AdamC19/Linear_Lab_Power_Supply/CAD/Linear_PSU_case_LID_Rear.stl

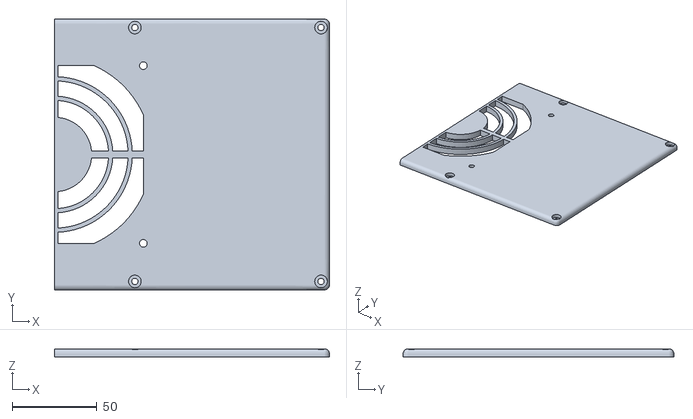
[picture p1: CAD file, 2022-03-09]
CAD/Linear_PSU_case_LID_Rear.stl
162.5 x 160.0 x 5.00
