AdamC19/Linear_Lab_Power_Supply/CAD/Linear_PSU_case_part_2.stl

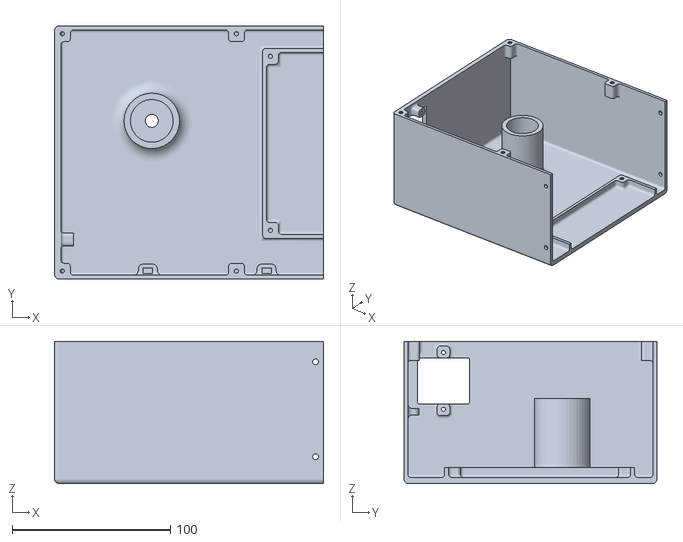
[picture p2: CAD file, 2022-03-09]
CAD/Linear_PSU_case_part_2.stl
170.0 x 160.0 x 90.0
