AdamC19/Linear_Lab_Power_Supply/CAD/Linear_PSU_part_1.stl

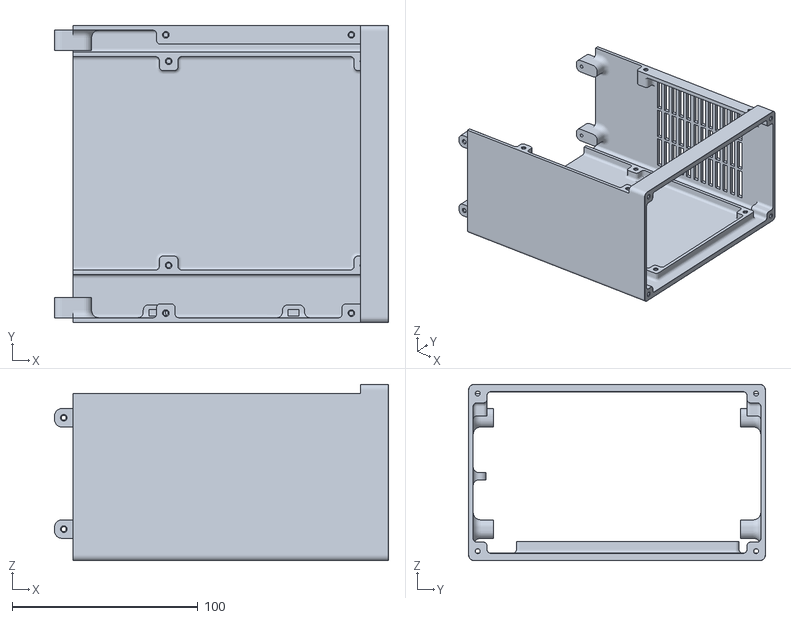
[picture p3: CAD file, 2022-03-09]
CAD/Linear_PSU_part_1.stl
180.0 x 160.0 x 95.0
