AdamC19/Linear_Lab_Power_Supply/(list of files, cad)

Other CAD files:
CAD/Linear_PSU_case_LID_Front.stl
