AdamC19/Linear_Lab_Power_Supply/Linear_Lab_Bench_PSU_front_panel/Linear_Lab_Bench_PSU_front_panel.kicad_pcb

## KiCad design Linear_Lab_Bench_PSU_front_panel/Linear_Lab_Bench_PSU_front_panel.kicad_pcb (2022-03-08)

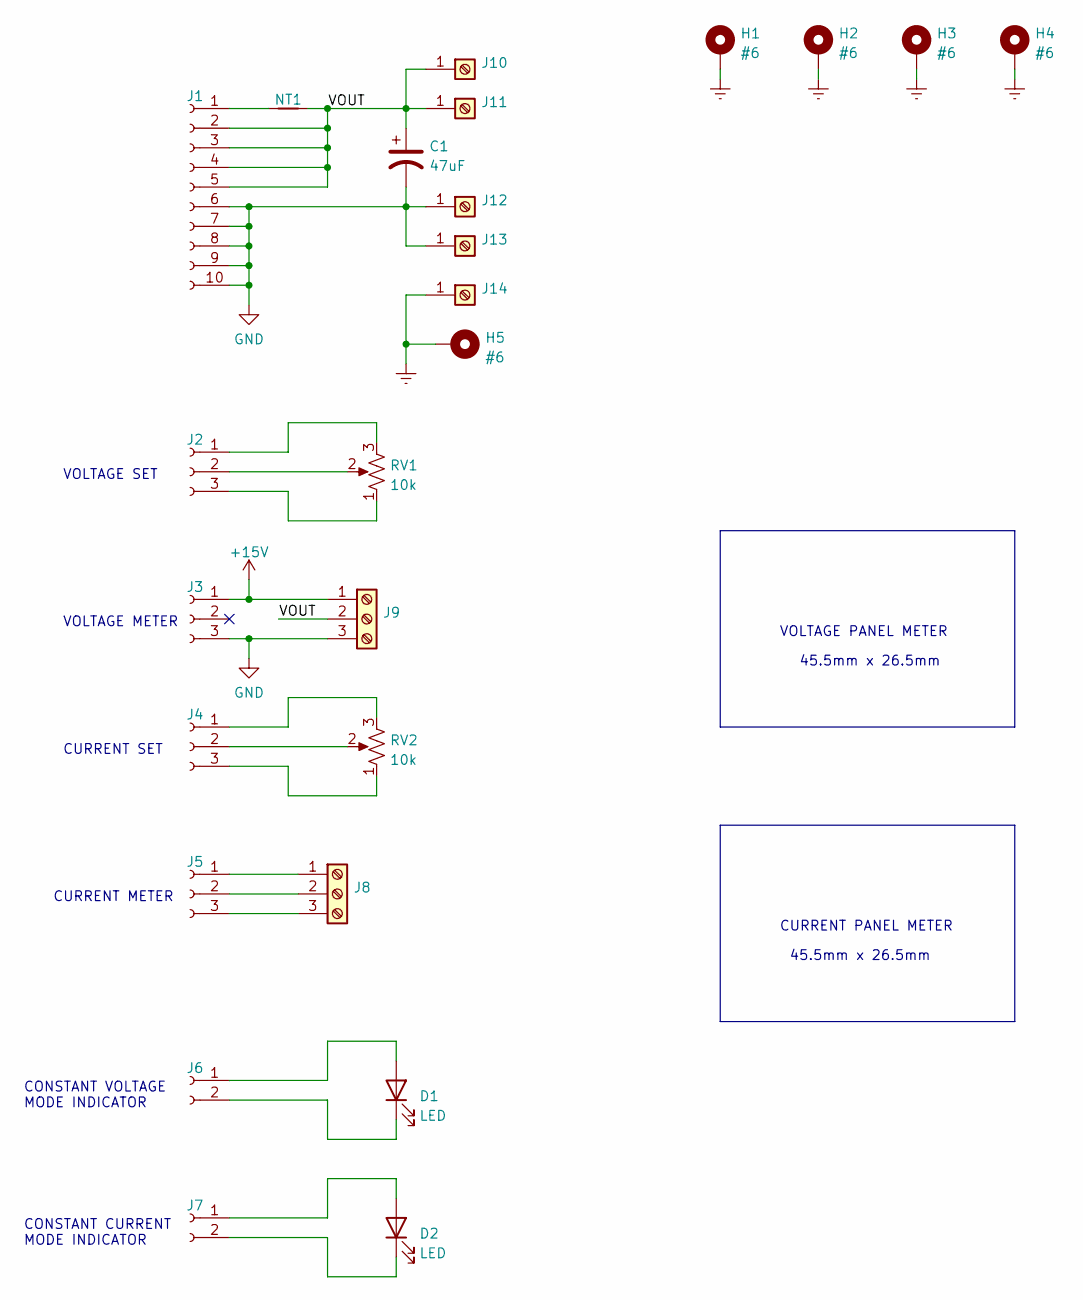
[picture p4: schematic Linear_Lab_Bench_PSU_front_panel.kicad_sch]

Parts:
C1: 47uF; CP_Radial_D8.0mm_P3.50mm
D1, D2: LED; LED_D5.0mm
H1, H2, H3, H4, H5: #6; MountingHole_3.7mm_Pad
J1: Conn_01x10_Female; PinSocket_1x10_P2.54mm_Vertical
J2, J3, J4, J5: Conn_01x03_Female; PinSocket_1x03_P2.54mm_Vertical
J6, J7: Conn_01x02_Female; PinSocket_1x02_P2.54mm_Vertical
J8, J9: Screw_Terminal_01x03; PhoenixContact_MCV_1,5_3-G-3.81_1x03_P3.81mm_Vertical
J10, J11, J12, J13, J14: Screw_Terminal_01x01; MountingHole_5.3mm_M5_Pad_Via
NT1: NetTie_2; NetTie-2_SMD_Pad0.5mm
RV1, RV2: 10k; Pot_TT_P160KNPD-4FC

Connections:
+15V: J3.1, J9.1
/VOUT: C1.1, J1.2, J1.3, J1.4, J1.5, J9.2, J10.1, J11.1, NT1.2
Earth: H1.1, H2.1, H3.1, H4.1, H5.1, J14.1
GND: C1.2, J1.6, J1.7, J1.8, J1.9, J1.10, J3.3, J9.3, J12.1, J13.1
unnamed: D1.1 (K), J6.2
unnamed: D1.2 (A), J6.1
unnamed: D2.1 (K), J7.2
unnamed: D2.2 (A), J7.1
unnamed: J1.1, NT1.1
unnamed: J2.1, RV1.3
unnamed: J2.2, RV1.2
unnamed: J2.3, RV1.1
unnamed: J4.1, RV2.3
unnamed: J4.2, RV2.2
unnamed: J4.3, RV2.1
unnamed: J5.1, J8.1
unnamed: J5.2, J8.2
unnamed: J5.3, J8.3

Notes on the sheet:
45.5mm x 26.5mm
VOLTAGE METER
CURRENT PANEL METER
CURRENT METER
VOLTAGE PANEL METER
CONSTANT CURRENT MODE INDICATOR
CURRENT SET
VOLTAGE SET
CONSTANT VOLTAGE MODE INDICATOR

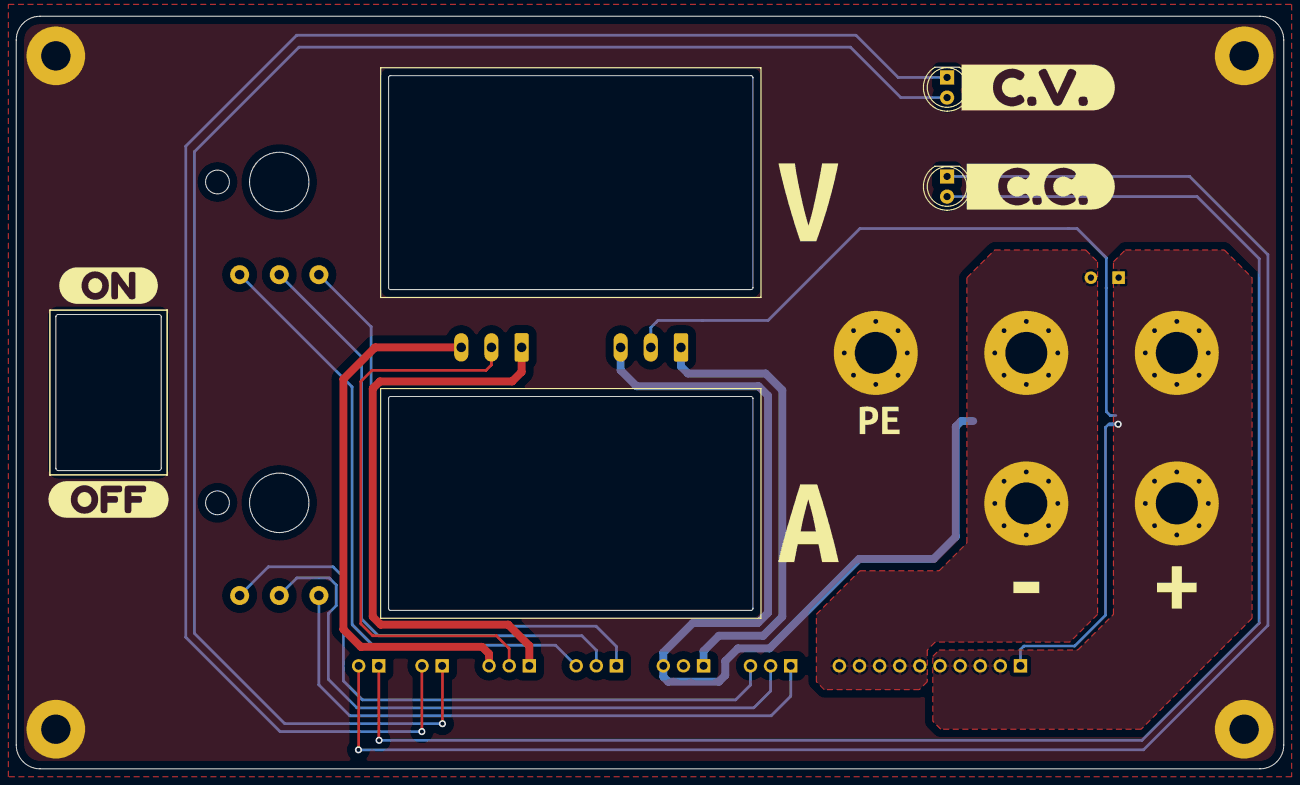
[picture p5: board Linear_Lab_Bench_PSU_front_panel.kicad_pcb from above]

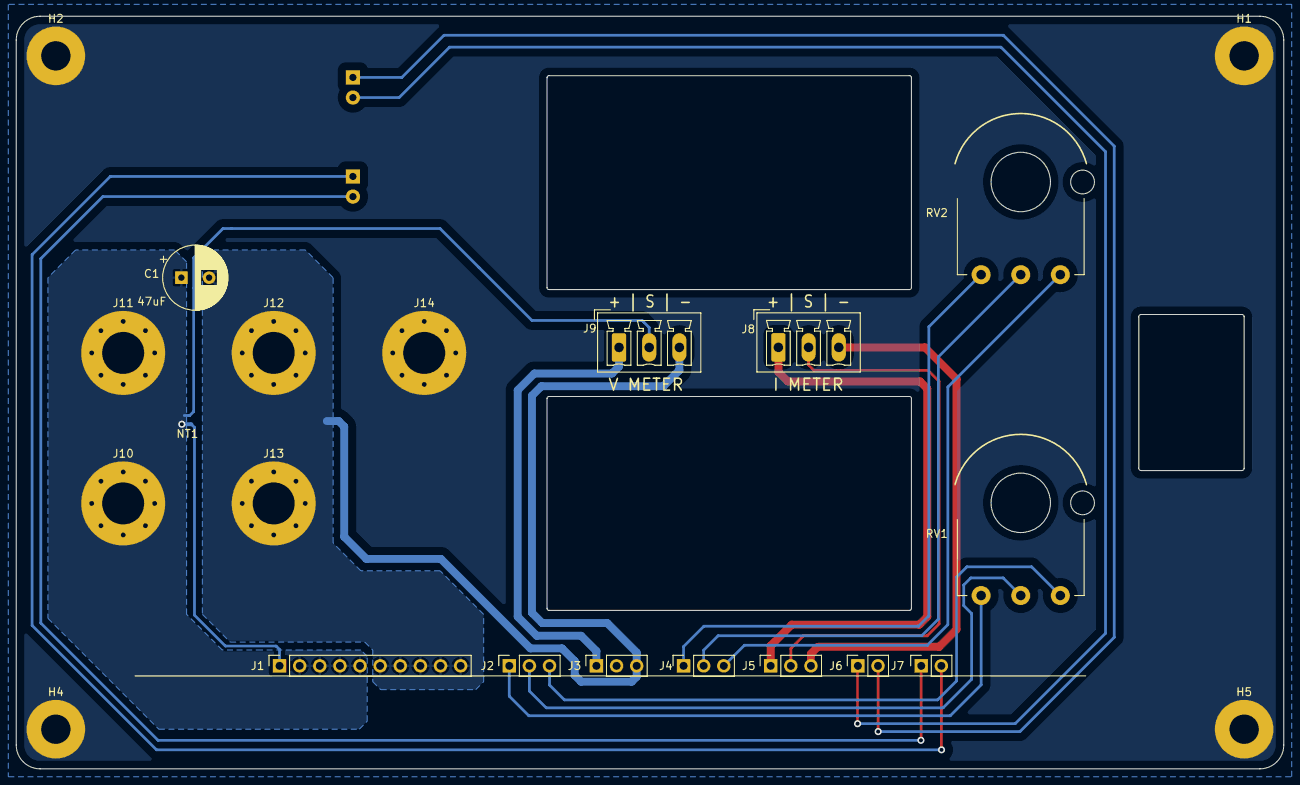
[picture p6: board Linear_Lab_Bench_PSU_front_panel.kicad_pcb from below]

Board: 2 copper layers, 160.0 x 95.0 mm, 33 parts (22 on the bottom side), 18 nets.

Other parts of the board:
kibuzzard-6225A7BC: G***; kibuzzard-6225A7BC
kibuzzard-6225A7C7: G***; kibuzzard-6225A7C7
kibuzzard-6225A77E: G***; kibuzzard-6225A77E
kibuzzard-6225A745: G***; kibuzzard-6225A745
kibuzzard-6225A755: G***; kibuzzard-6225A755
kibuzzard-62263B3C: G***; kibuzzard-62263B3C
kibuzzard-62263B33: G***; kibuzzard-62263B33
kibuzzard-62263C4A: G***; kibuzzard-62263C4A
kibuzzard-62263C42: G***; kibuzzard-62263C42
