AdamC19/Linear_Lab_Power_Supply/Linear_Lab_Bench_PSU_main/Linear_Lab_Bench_PSU.kicad_pcb

## KiCad design Linear_Lab_Bench_PSU_main/Linear_Lab_Bench_PSU.kicad_pcb (2022-03-08)

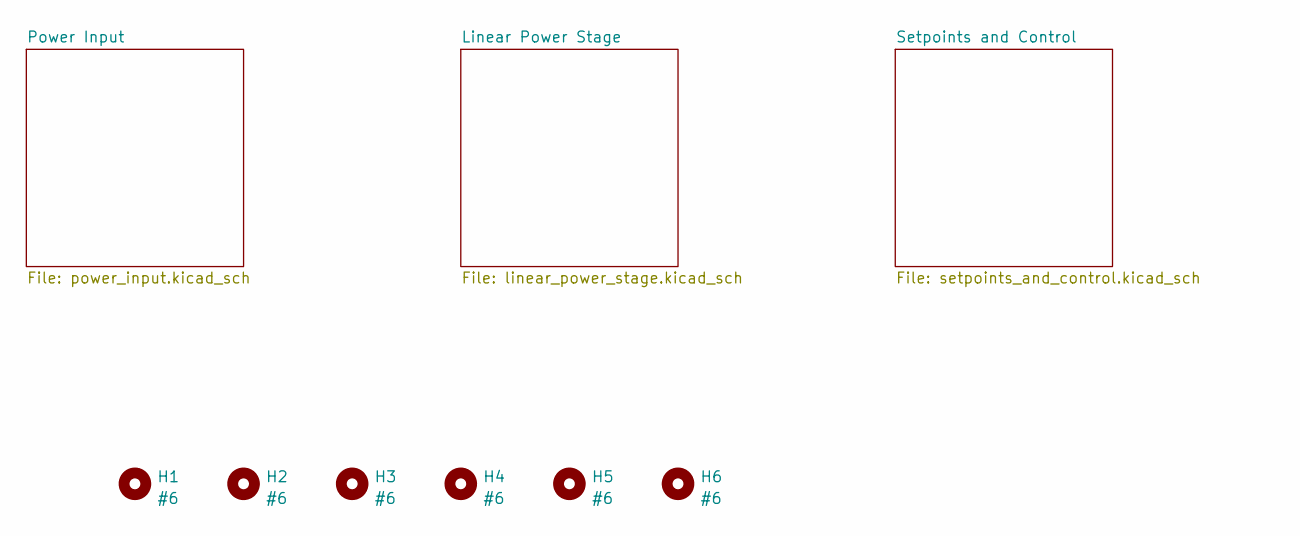
[picture p7: schematic Linear_Lab_Bench_PSU.kicad_sch]

Parts:
H1, H2, H3, H4, H5, H6: #6; MountingHole_3.7mm_Pad

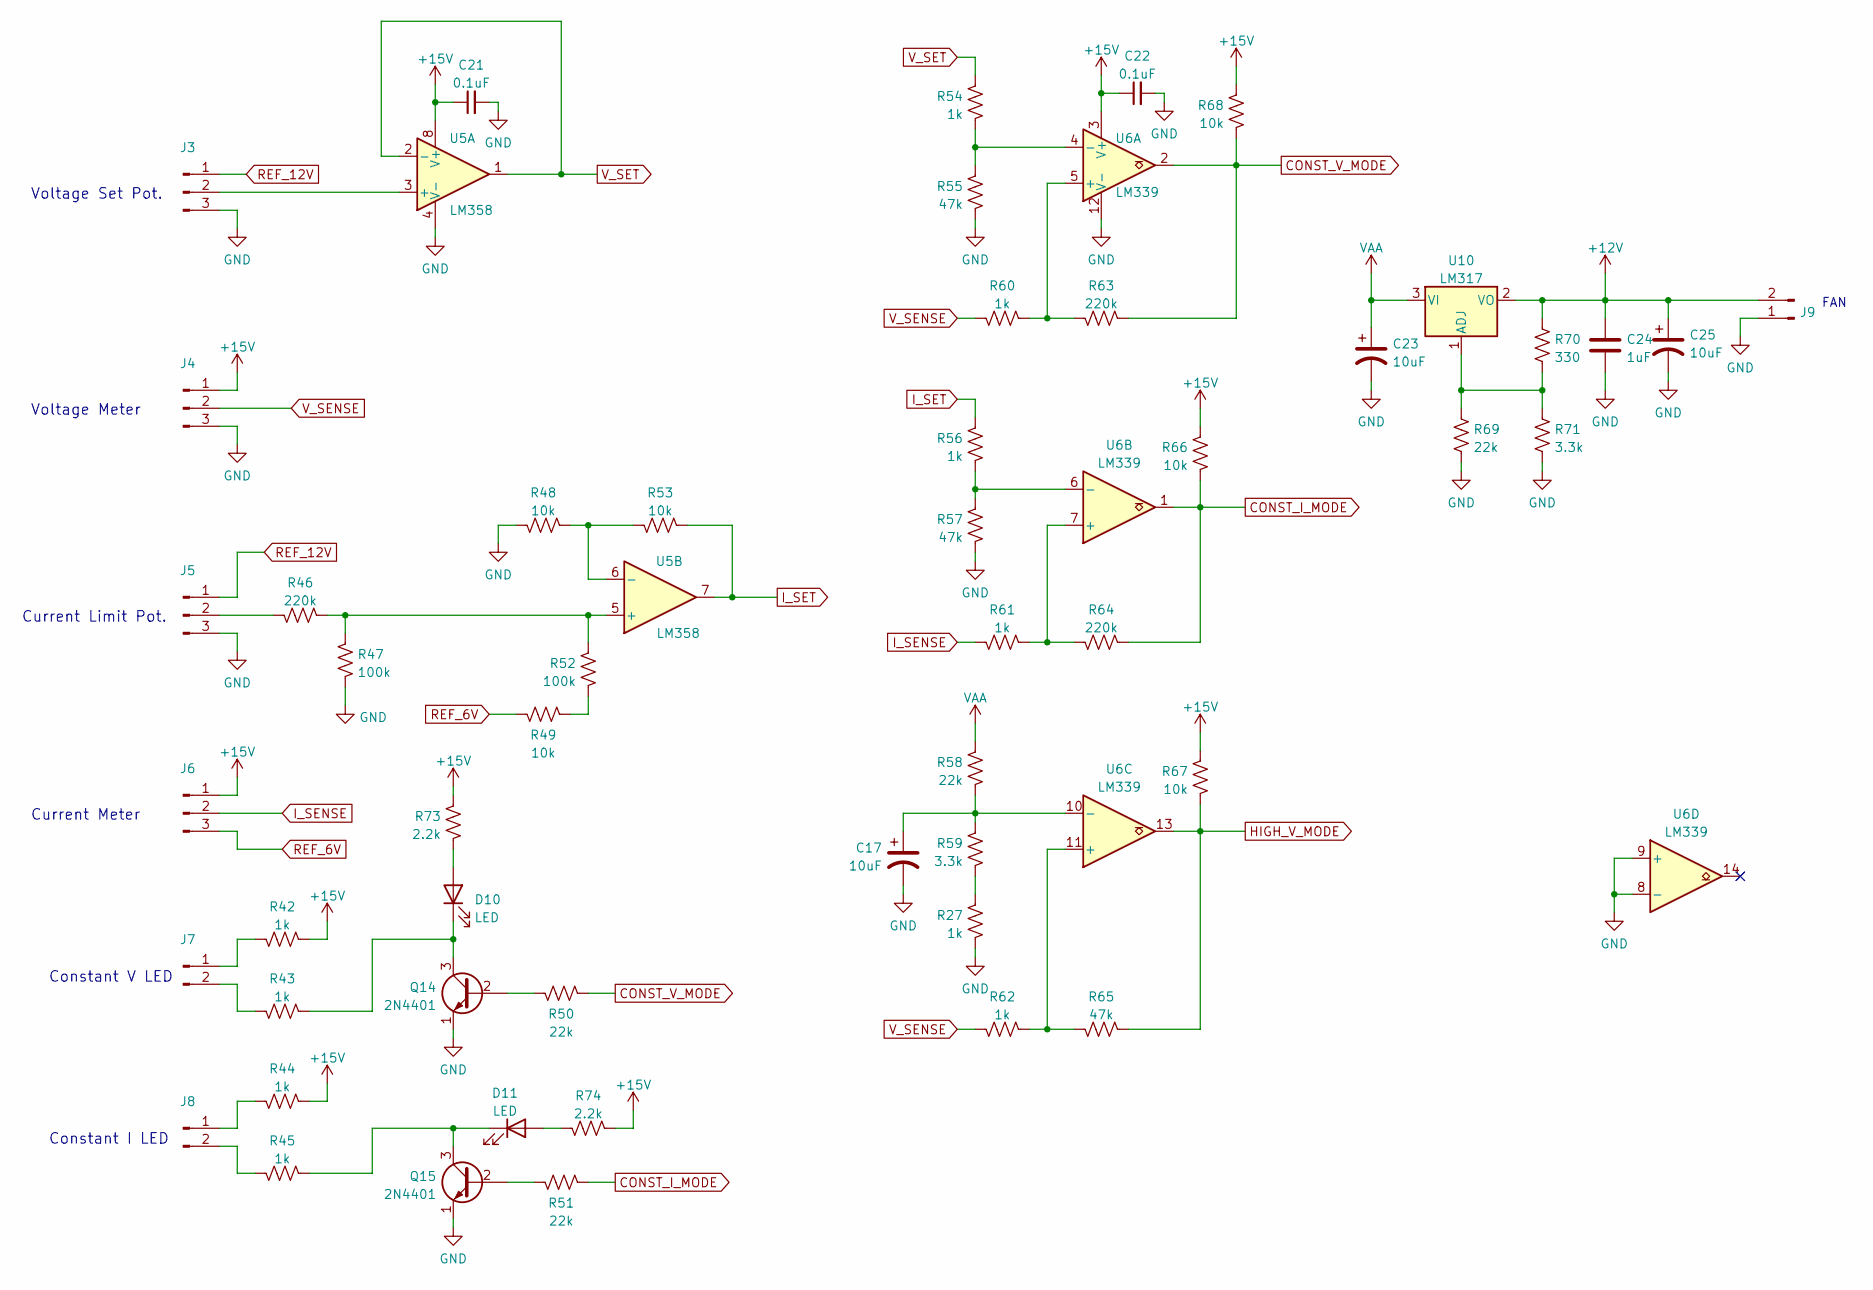
[picture p8: schematic setpoints_and_control.kicad_sch]

Parts:
C17, C23, C25: 10uF; CP_Radial_D5.0mm_P2.50mm
C21, C22: 0.1uF; C_Disc_D5.0mm_W2.5mm_P2.50mm
C24: 1uF; C_Axial_L5.1mm_D3.1mm_P7.50mm_Horizontal
D10, D11: LED; LED_D5.0mm
J3, J4, J5, J6: Conn_01x03_Male; PinHeader_1x03_P2.54mm_Horizontal
J7, J8: Conn_01x02_Male; PinHeader_1x02_P2.54mm_Horizontal
J9: Conn_01x02_Male; PinHeader_1x02_P2.54mm_Vertical
Q14, Q15: 2N4401; TO-92_Inline_Wide
R27, R42, R43, R44, R45, R54, R56, R60, R61, R62: 1k; R_Axial_DIN0207_L6.3mm_D2.5mm_P10.16mm_Horizontal
R46, R63, R64: 220k; R_Axial_DIN0207_L6.3mm_D2.5mm_P10.16mm_Horizontal
R47, R52: 100k; R_Axial_DIN0207_L6.3mm_D2.5mm_P10.16mm_Horizontal
R48, R49, R53, R66, R67, R68: 10k; R_Axial_DIN0207_L6.3mm_D2.5mm_P10.16mm_Horizontal
R50, R51, R58, R69: 22k; R_Axial_DIN0207_L6.3mm_D2.5mm_P10.16mm_Horizontal
R55, R57, R65: 47k; R_Axial_DIN0207_L6.3mm_D2.5mm_P10.16mm_Horizontal
R59, R71: 3.3k; R_Axial_DIN0207_L6.3mm_D2.5mm_P10.16mm_Horizontal
R70: 330; R_Axial_DIN0207_L6.3mm_D2.5mm_P10.16mm_Horizontal
R73, R74: 2.2k; R_Axial_DIN0207_L6.3mm_D2.5mm_P10.16mm_Horizontal
U5: LM358; DIP-8_W7.62mm
U6: LM339; DIP-14_W7.62mm
U10: LM317; TO-220-3_Vertical

Connections:
+12V: C24.1, C25.1, J9.2, R70.1, U10.2 (VO)
+15V: C21.1, C22.1, J4.1, J6.1, R42.2, R44.2, R66.2, R67.2, R68.2, R73.2, R74.2, U5.8 (V+), U6.3 (V+); also elsewhere on the board
CONST_I_MODE: R51.1, R64.2, R66.1, U6.1
CONST_V_MODE: R50.1, R63.2, R68.1, U6.2
GND: C17.2, C21.2, C22.2, C23.2, C24.2, C25.2, J3.3, J4.3, J5.3, J9.1, Q14.1 (E), Q15.1 (E), R27.1, R47.2, R48.1, R55.1, R57.1, R69.2, R71.2, U5.4 (V-), U6.8 (-), U6.9 (+), U6.12 (V-); also elsewhere on the board
HIGH_V_MODE: R65.2, R67.1, U6.13; also elsewhere on the board
I_SENSE: J6.2, R61.2; also elsewhere on the board
I_SET: R53.2, R56.2, U5.7; also elsewhere on the board
unnamed: C17.1, R58.1, R59.2, U6.10 (-)
unnamed: D10.1 (K), Q14.3 (C), R43.2
unnamed: D10.2 (A), R73.1
unnamed: D11.1 (K), Q15.3 (C), R45.2
unnamed: D11.2 (A), R74.1
unnamed: J3.2, U5.3 (+)
unnamed: J5.2, R46.2
unnamed: J7.1, R42.1
unnamed: J7.2, R43.1
unnamed: J8.1, R44.1
unnamed: J8.2, R45.1
unnamed: Q14.2 (B), R50.2
unnamed: Q15.2 (B), R51.2
unnamed: R27.2, R59.1
unnamed: R46.1, R47.1, R52.2, U5.5 (+)
unnamed: R48.2, R53.1, U5.6 (-)
unnamed: R49.1, R52.1
unnamed: R54.1, R55.2, U6.4 (-)
unnamed: R56.1, R57.2, U6.6 (-)
unnamed: R60.1, R63.1, U6.5 (+)
unnamed: R61.1, R64.1, U6.7 (+)
unnamed: R62.1, R65.1, U6.11 (+)
unnamed: R69.1, R70.2, R71.1, U10.1 (ADJ)
REF_6V: J6.3, R49.2; also elsewhere on the board
REF_12V: J3.1, J5.1; also elsewhere on the board
VAA: C23.1, R58.2, U10.3 (VI); also elsewhere on the board
V_SENSE: J4.2, R60.2, R62.2; also elsewhere on the board
V_SET: R54.2, U5.1, U5.2 (-); also elsewhere on the board

Notes on the sheet:
Constant I LED
Voltage Meter
Constant V LED
Voltage Set Pot.
FAN
Current Limit Pot.
Current Meter

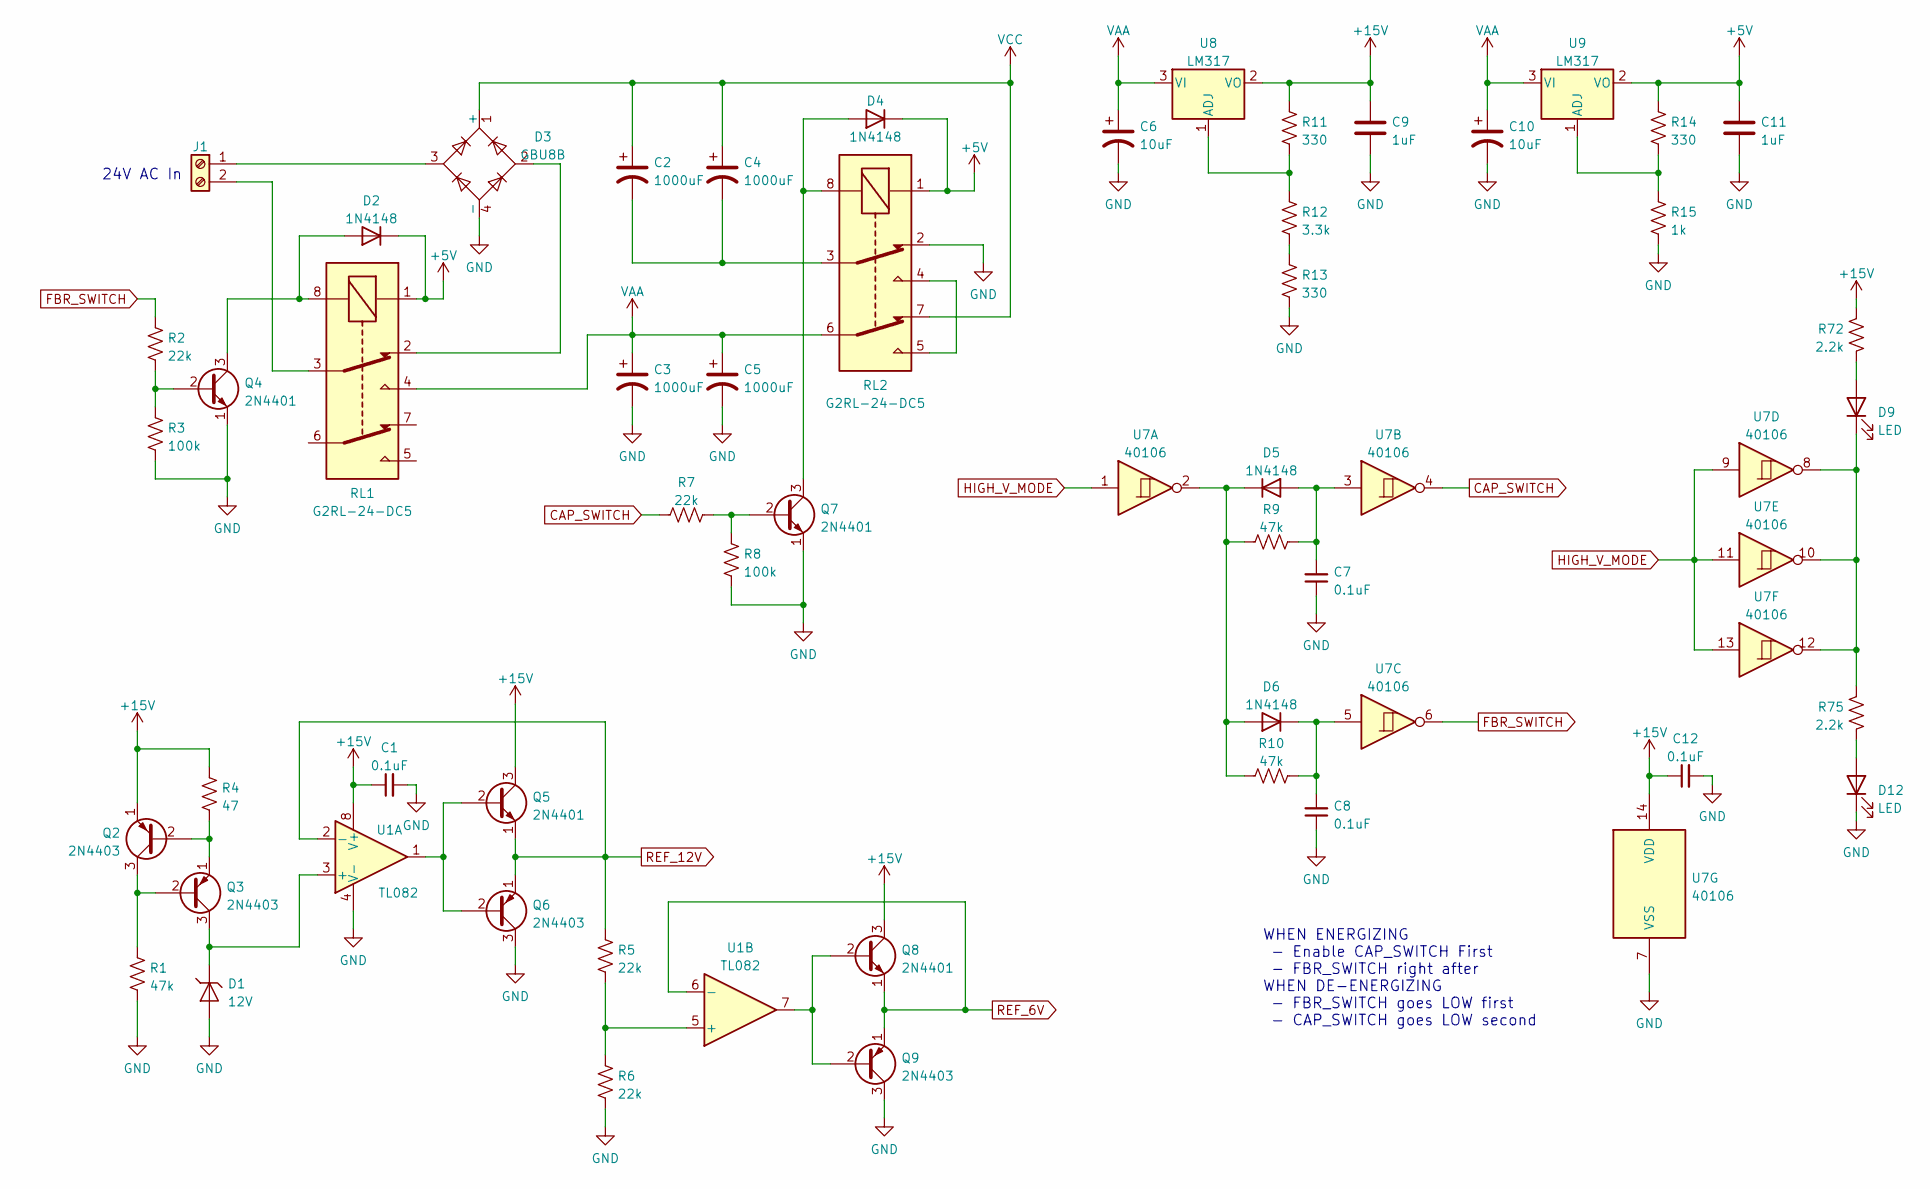
[picture p9: schematic power_input.kicad_sch]

Parts:
C1, C7, C8, C12: 0.1uF; C_Disc_D5.0mm_W2.5mm_P2.50mm
C2: 1000uF; CP_Radial_D16.0mm_P7.50mm; MFG_PN EKY-500ELL102ML25S
C3, C4, C5: 1000uF; CP_Radial_D16.0mm_P7.50mm
C6, C10: 10uF; CP_Radial_D5.0mm_P2.50mm
C9, C11: 1uF; C_Axial_L5.1mm_D3.1mm_P7.50mm_Horizontal
D1: 12V; D_DO-41_SOD81_P10.16mm_Horizontal
D2, D4, D5, D6: 1N4148; D_DO-35_SOD27_P7.62mm_Horizontal
D3: GBU8B; Diode_Bridge_Vishay_GBU
D9, D12: LED; LED_D5.0mm
J1: Screw_Terminal_01x02; PhoenixContact_GMSTBA_2,5_2-G-7,62_1x02_P7.62mm_Horizontal
Q2, Q3, Q6, Q9: 2N4403; TO-92_Inline_Wide
Q4, Q5, Q7, Q8: 2N4401; TO-92_Inline_Wide
R1, R9, R10: 47k; R_Axial_DIN0207_L6.3mm_D2.5mm_P10.16mm_Horizontal
R2, R5, R6, R7: 22k; R_Axial_DIN0207_L6.3mm_D2.5mm_P10.16mm_Horizontal
R3, R8: 100k; R_Axial_DIN0207_L6.3mm_D2.5mm_P10.16mm_Horizontal
R4: 47; R_Axial_DIN0207_L6.3mm_D2.5mm_P10.16mm_Horizontal
R11, R13, R14: 330; R_Axial_DIN0207_L6.3mm_D2.5mm_P10.16mm_Horizontal
R12: 3.3k; R_Axial_DIN0207_L6.3mm_D2.5mm_P10.16mm_Horizontal
R15: 1k; R_Axial_DIN0207_L6.3mm_D2.5mm_P10.16mm_Horizontal
R72, R75: 2.2k; R_Axial_DIN0207_L6.3mm_D2.5mm_P10.16mm_Horizontal
RL1, RL2: G2RL-24-DC5; Relay_DPDT_Omron_G2RL
U1: TL082; DIP-8_W7.62mm
U7: 40106; DIP-14_W7.62mm
U8, U9: LM317; TO-220-3_Vertical

Connections:
+5V: C11.1, D2.1 (K), D4.1 (K), R14.1, RL1.1, RL2.1, U9.2 (VO)
+15V: C1.1, C9.1, C12.1, Q2.1 (E), Q5.3 (C), Q8.3 (C), R4.1, R11.1, R72.2, U1.8 (V+), U7.14 (VDD), U8.2 (VO); also elsewhere on the board
CAP_SWITCH: R7.2, U7.4
FBR_SWITCH: R2.2, U7.6
GND: C1.2, C3.2, C5.2, C6.2, C7.1, C8.1, C9.2, C10.2, C11.2, C12.2, D1.2 (A), D3.4 (-), D12.1 (K), Q4.1 (E), Q6.3 (C), Q7.1 (E), Q9.3 (C), R1.2, R3.1, R6.2, R8.1, R13.2, R15.2, RL2.2, U1.4 (V-), U7.7 (VSS); also elsewhere on the board
HIGH_V_MODE: U7.1, U7.9, U7.11, U7.13; also elsewhere on the board
unnamed: C2.2, C4.2, RL2.3
unnamed: C7.2, D5.2 (A), R9.2, U7.3
unnamed: C8.2, D6.1 (K), R10.2, U7.5
unnamed: D1.1 (K), Q3.3 (C), U1.3 (+)
unnamed: D2.2 (A), Q4.3 (C), RL1.8
unnamed: D3.2, RL1.2
unnamed: D3.3, J1.1
unnamed: D4.2 (A), Q7.3 (C), RL2.8
unnamed: D5.1 (K), D6.2 (A), R9.1, R10.1, U7.2
unnamed: D9.1 (K), R75.2, U7.8, U7.10, U7.12
unnamed: D9.2 (A), R72.1
unnamed: D12.2 (A), R75.1
unnamed: J1.2, RL1.3
unnamed: Q2.2 (B), Q3.1 (E), R4.2
unnamed: Q2.3 (C), Q3.2 (B), R1.1
unnamed: Q4.2 (B), R2.1, R3.2
unnamed: Q5.2 (B), Q6.2 (B), U1.1
unnamed: Q7.2 (B), R7.1, R8.2
unnamed: Q8.2 (B), Q9.2 (B), U1.7
unnamed: R5.2, R6.1, U1.5 (+)
unnamed: R11.2, R12.1, U8.1 (ADJ)
unnamed: R12.2, R13.1
unnamed: R14.2, R15.1, U9.1 (ADJ)
unnamed: RL2.4, RL2.5
REF_6V: Q8.1 (E), Q9.1 (E), U1.6 (-); also elsewhere on the board
REF_12V: Q5.1 (E), Q6.1 (E), R5.1, U1.2 (-); also elsewhere on the board
VAA: C3.1, C5.1, C6.1, C10.1, RL1.4, RL2.6, U8.3 (VI), U9.3 (VI); also elsewhere on the board
VCC: C2.1, C4.1, D3.1 (+), RL2.7; also elsewhere on the board

Notes on the sheet:
WHEN ENERGIZING - Enable CAP_SWITCH First - FBR_SWITCH right after WHEN DE-ENERGIZING - FBR_SWITCH goes LOW first - CAP_SWITCH goes LOW second
24V AC In

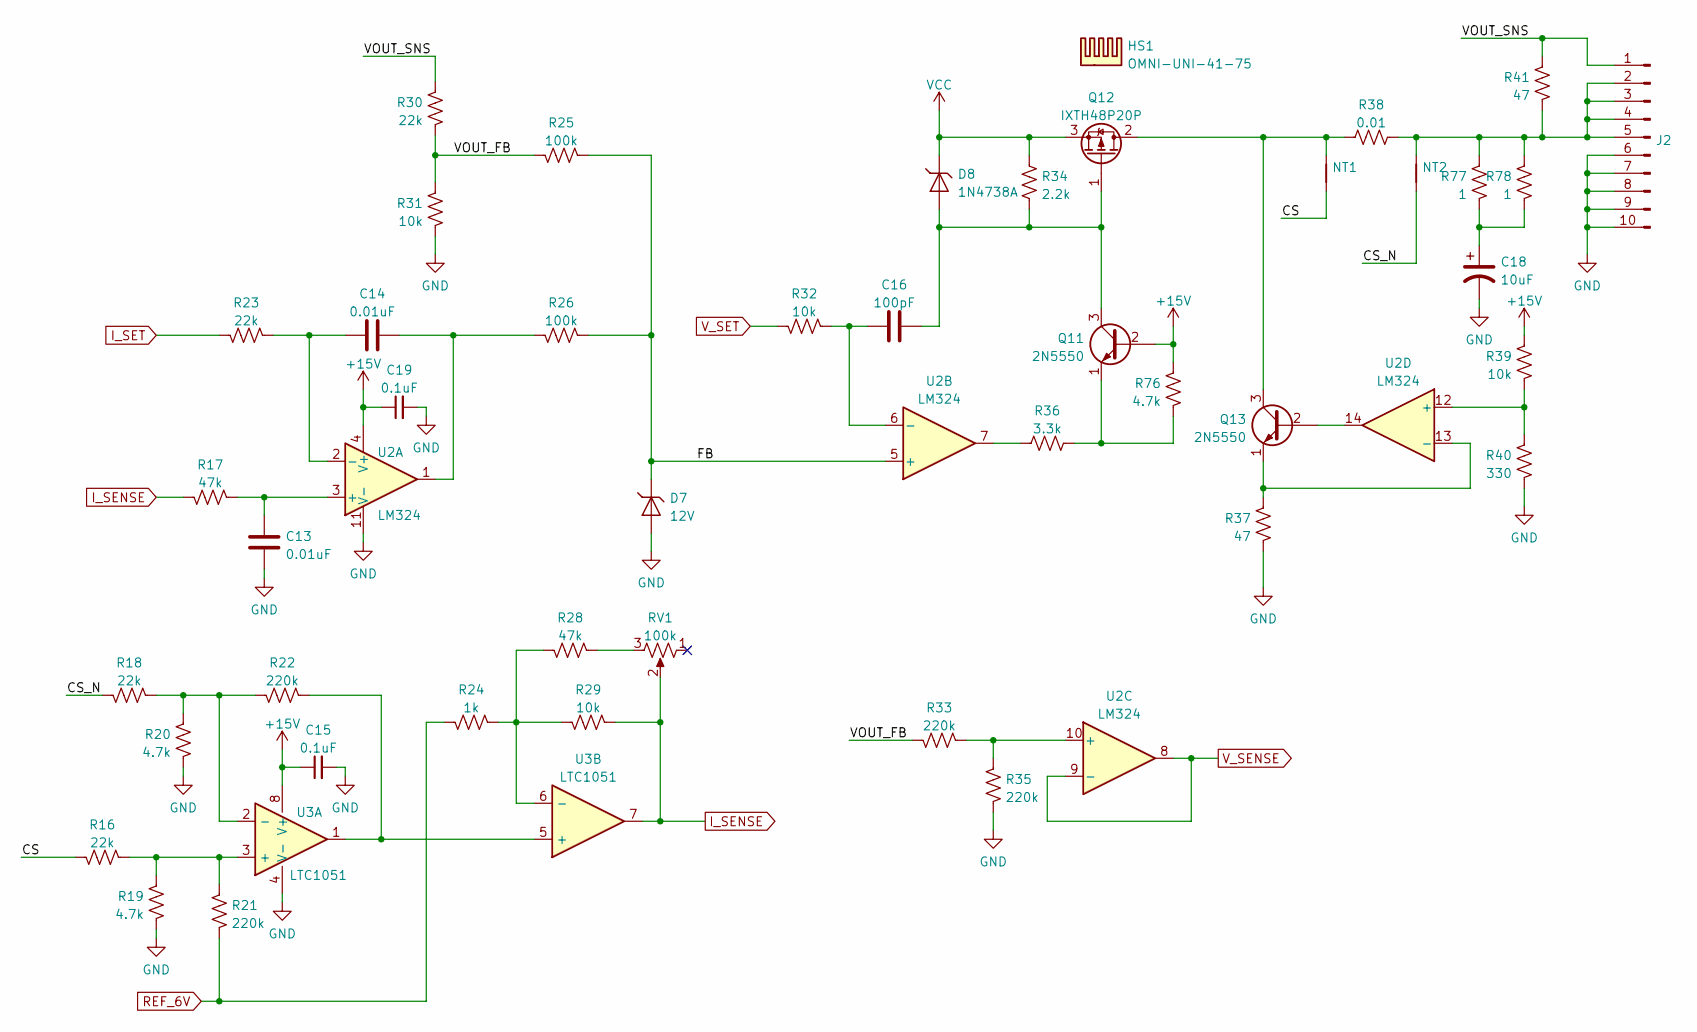
[picture p10: schematic linear_power_stage.kicad_sch]

Parts:
C13, C14: 0.01uF; C_Disc_D7.0mm_W2.5mm_P5.00mm
C15, C19: 0.1uF; C_Disc_D5.0mm_W2.5mm_P2.50mm
C16: 100pF; C_Disc_D5.0mm_W2.5mm_P2.50mm
C18: 10uF; CP_Radial_D5.0mm_P2.50mm
D7: 12V; D_DO-41_SOD81_P10.16mm_Horizontal
D8: 1N4738A; D_DO-41_SOD81_P10.16mm_Horizontal
HS1: OMNI-UNI-41-75; Wakefield_Vette_OMNI-UNI-41-75
J2: Conn_01x10_Male; PinHeader_1x10_P2.54mm_Horizontal
NT1, NT2: NetTie_2; NetTie-2_SMD_Pad0.5mm
Q11, Q13: 2N5550; TO-92_Inline_Wide
Q12: IXTH48P20P; TO-247-3_Vertical
R16, R18, R23, R30: 22k; R_Axial_DIN0207_L6.3mm_D2.5mm_P10.16mm_Horizontal
R17, R28: 47k; R_Axial_DIN0207_L6.3mm_D2.5mm_P10.16mm_Horizontal
R19, R20, R76: 4.7k; R_Axial_DIN0207_L6.3mm_D2.5mm_P10.16mm_Horizontal
R21, R22, R33, R35: 220k; R_Axial_DIN0207_L6.3mm_D2.5mm_P10.16mm_Horizontal
R24: 1k; R_Axial_DIN0207_L6.3mm_D2.5mm_P10.16mm_Horizontal
R25, R26: 100k; R_Axial_DIN0207_L6.3mm_D2.5mm_P10.16mm_Horizontal
R29, R31, R32, R39: 10k; R_Axial_DIN0207_L6.3mm_D2.5mm_P10.16mm_Horizontal
R34: 2.2k; R_Axial_DIN0207_L6.3mm_D2.5mm_P10.16mm_Horizontal
R36: 3.3k; R_Axial_DIN0207_L6.3mm_D2.5mm_P10.16mm_Horizontal
R37, R41: 47; R_Axial_DIN0207_L6.3mm_D2.5mm_P10.16mm_Horizontal
R38: 0.01; R_Bare_Metal_Element_L16.3mm_W4.8mm_P15.30mm; MFG_PN BR3FB10L0
R40: 330; R_Axial_DIN0207_L6.3mm_D2.5mm_P10.16mm_Horizontal
R77, R78: 1; R_Axial_DIN0207_L6.3mm_D2.5mm_P10.16mm_Horizontal
RV1: 100k; Potentiometer_Bourns_3386P_Vertical
U2: LM324; DIP-14_W7.62mm
U3: LTC1051; DIP-8_W7.62mm

Connections:
+15V: C15.1, C19.1, Q11.2 (B), R39.2, R76.2, U2.4 (V+), U3.8 (V+); also elsewhere on the board
/Linear Power Stage/CS: NT1.1, R16.2
/Linear Power Stage/CS_N: NT2.1, R18.2
/Linear Power Stage/FB: D7.1 (K), R25.1, R26.1, U2.5 (+)
/Linear Power Stage/VOUT_FB: R25.2, R30.1, R31.2, R33.2
/Linear Power Stage/VOUT_SNS: J2.1, R30.2, R41.1
GND: C13.2, C15.2, C18.2, C19.2, D7.2 (A), J2.6, J2.7, J2.8, J2.9, J2.10, R19.1, R20.1, R31.1, R35.2, R37.2, R40.1, U2.11 (V-), U3.4 (V-); also elsewhere on the board
I_SENSE: R17.2, R29.1, RV1.2, U3.7; also elsewhere on the board
I_SET: R23.2; also elsewhere on the board
unnamed: C13.1, R17.1, U2.3 (+)
unnamed: C14.1, R23.1, U2.2 (-)
unnamed: C14.2, R26.2, U2.1
unnamed: C16.1, R32.1, U2.6 (-)
unnamed: C16.2, D8.2 (A), Q11.3 (C), Q12.1 (G), R34.2
unnamed: C18.1, R77.2, R78.2
unnamed: J2.2, J2.3, J2.4, J2.5, NT2.2, R38.2, R41.2, R77.1, R78.1
unnamed: NT1.2, Q12.2 (D), Q13.3 (C), R38.1
unnamed: Q11.1 (E), R36.2, R76.1
unnamed: Q13.1 (E), R37.1, U2.13 (-)
unnamed: Q13.2 (B), U2.14
unnamed: R16.1, R19.2, R21.1, U3.3 (+)
unnamed: R18.1, R20.2, R22.2, U3.2 (-)
unnamed: R22.1, U3.1, U3.5 (+)
unnamed: R24.1, R28.2, R29.2, U3.6 (-)
unnamed: R28.1, RV1.3
unnamed: R33.1, R35.1, U2.10 (+)
unnamed: R36.1, U2.7
unnamed: R39.1, R40.2, U2.12 (+)
REF_6V: R21.2, R24.2; also elsewhere on the board
VCC: D8.1 (K), Q12.3 (S), R34.1; also elsewhere on the board
V_SENSE: U2.8, U2.9 (-); also elsewhere on the board
V_SET: R32.2; also elsewhere on the board

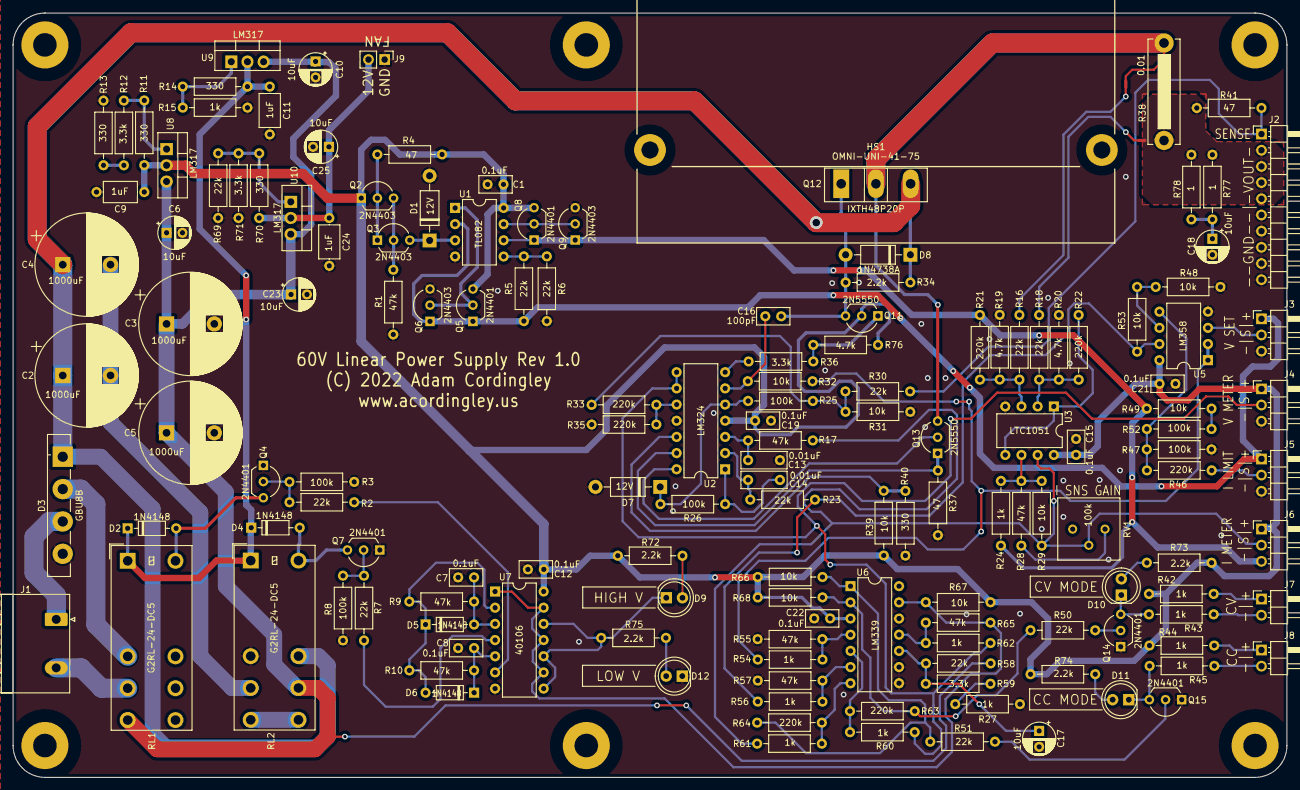
[picture p11: board Linear_Lab_Bench_PSU.kicad_pcb from above]

Board: 2 copper layers, 200.0 x 120.0 mm, 157 parts (0 on the bottom side), 88 nets.
