AdamC19/Linear_Lab_Power_Supply/(commit log)

2022-03-09 Add 3D Models and STLs for case
    [Linear_PSU_case_LID_Front.stl, Linear_PSU_case_LID_Rear.stl, Linear_PSU_case_part_2.stl, Linear_PSU_part_1.stl]
2022-03-20 Notes on schematic for resistor changes
    [linear_power_stage.kicad_sch, setpoints_and_control.kicad_sch]
