AdamC19/Linear_Lab_Power_Supply/(notices)

Notices in the files:
Linear_Lab_Bench_PSU_main/Linear_Lab_Bench_PSU.kicad_pcb:
(C) 2022 Adam Cordingley
